brentdewe/ropuf/demo/demo_puf.py

#!/usr/bin/python3

import numpy as np  #> pip install numpy
import serial  #> pip install pyserial
from Crypto.Cipher import AES  #> pip install pycrypto

from base64 import b64decode
import hashlib
import math
import subprocess


MATLAB = '/opt/MATLAB/R2020b/bin/matlab'
PORT = '/dev/ttyUSB1'
N_PROVISIONS = 100
N = 255
K = 187

response_Nbytes = math.ceil(K / 8)


def data2bits(data):
	bits = np.zeros(len(data) * 8, np.uint8)
	for i in range(len(data)):
		b = data[i]
		for j in range(8):
			bits[i * 8 + j] = b % 2
			b >>= 1
	return bits

def hamming_dist(a, b):
	return int(np.sum((a + b) % 2))

def bits2str(bits):
	return ''.join(map(str, reversed(bits)))

def str2bytes(bitstring):
	Nbytes = math.ceil(len(bitstring) / 8)
	return int(bitstring, 2).to_bytes(Nbytes, 'little')


# Provisioning

reference = np.zeros(K, dtype=int)
with serial.Serial(PORT, 230400) as ser:
	for _ in range(N_PROVISIONS):
		ser.write(b'p')
		response = data2bits(ser.read(response_Nbytes))
		reference += response[:K]
reference = np.uint8(np.round(reference / N_PROVISIONS))
print('Reference response:')
print(bits2str(reference))
#print('Uniformity:', reference.sum() / K)
print()

# Syndrome response

resp = bits2str(reference)
matlabresult = subprocess.run((MATLAB, '-nodisplay', '-nojvm', '-batch', 'bch ' + resp),
		capture_output=True)
if len(matlabresult.stderr) > 0:
	print(matlabresult.stderr)
s = matlabresult.stdout.strip()
syndrome = s
print('Syndrome:', syndrome.decode())
print()
syndrome_bytes = str2bytes(syndrome)
with serial.Serial(PORT, 230400) as ser:
	ser.write(b's')
	ser.write(syndrome_bytes)
	response = data2bits(ser.read(response_Nbytes))[:K]
print('Response:')
print(bits2str(response))
print('Number of bit errors:', hamming_dist(reference, response))
print()

# Key generation

key = hashlib.sha256(str2bytes(bits2str(response)))
print('Hashed key:', key.hexdigest())
print()

# Message decryption

encrypted = input('Input encrypted message: ')
cipher = AES.new(key.digest(), AES.MODE_ECB)
message = cipher.decrypt(b64decode(encrypted)).rstrip(b'\x00')
print('Message:', message.decode())
